Galacs/rollxoxo-shim/rollxoxo-shim.kicad_pcb

## KiCad design rollxoxo-shim.kicad_pcb (2026-06-30)

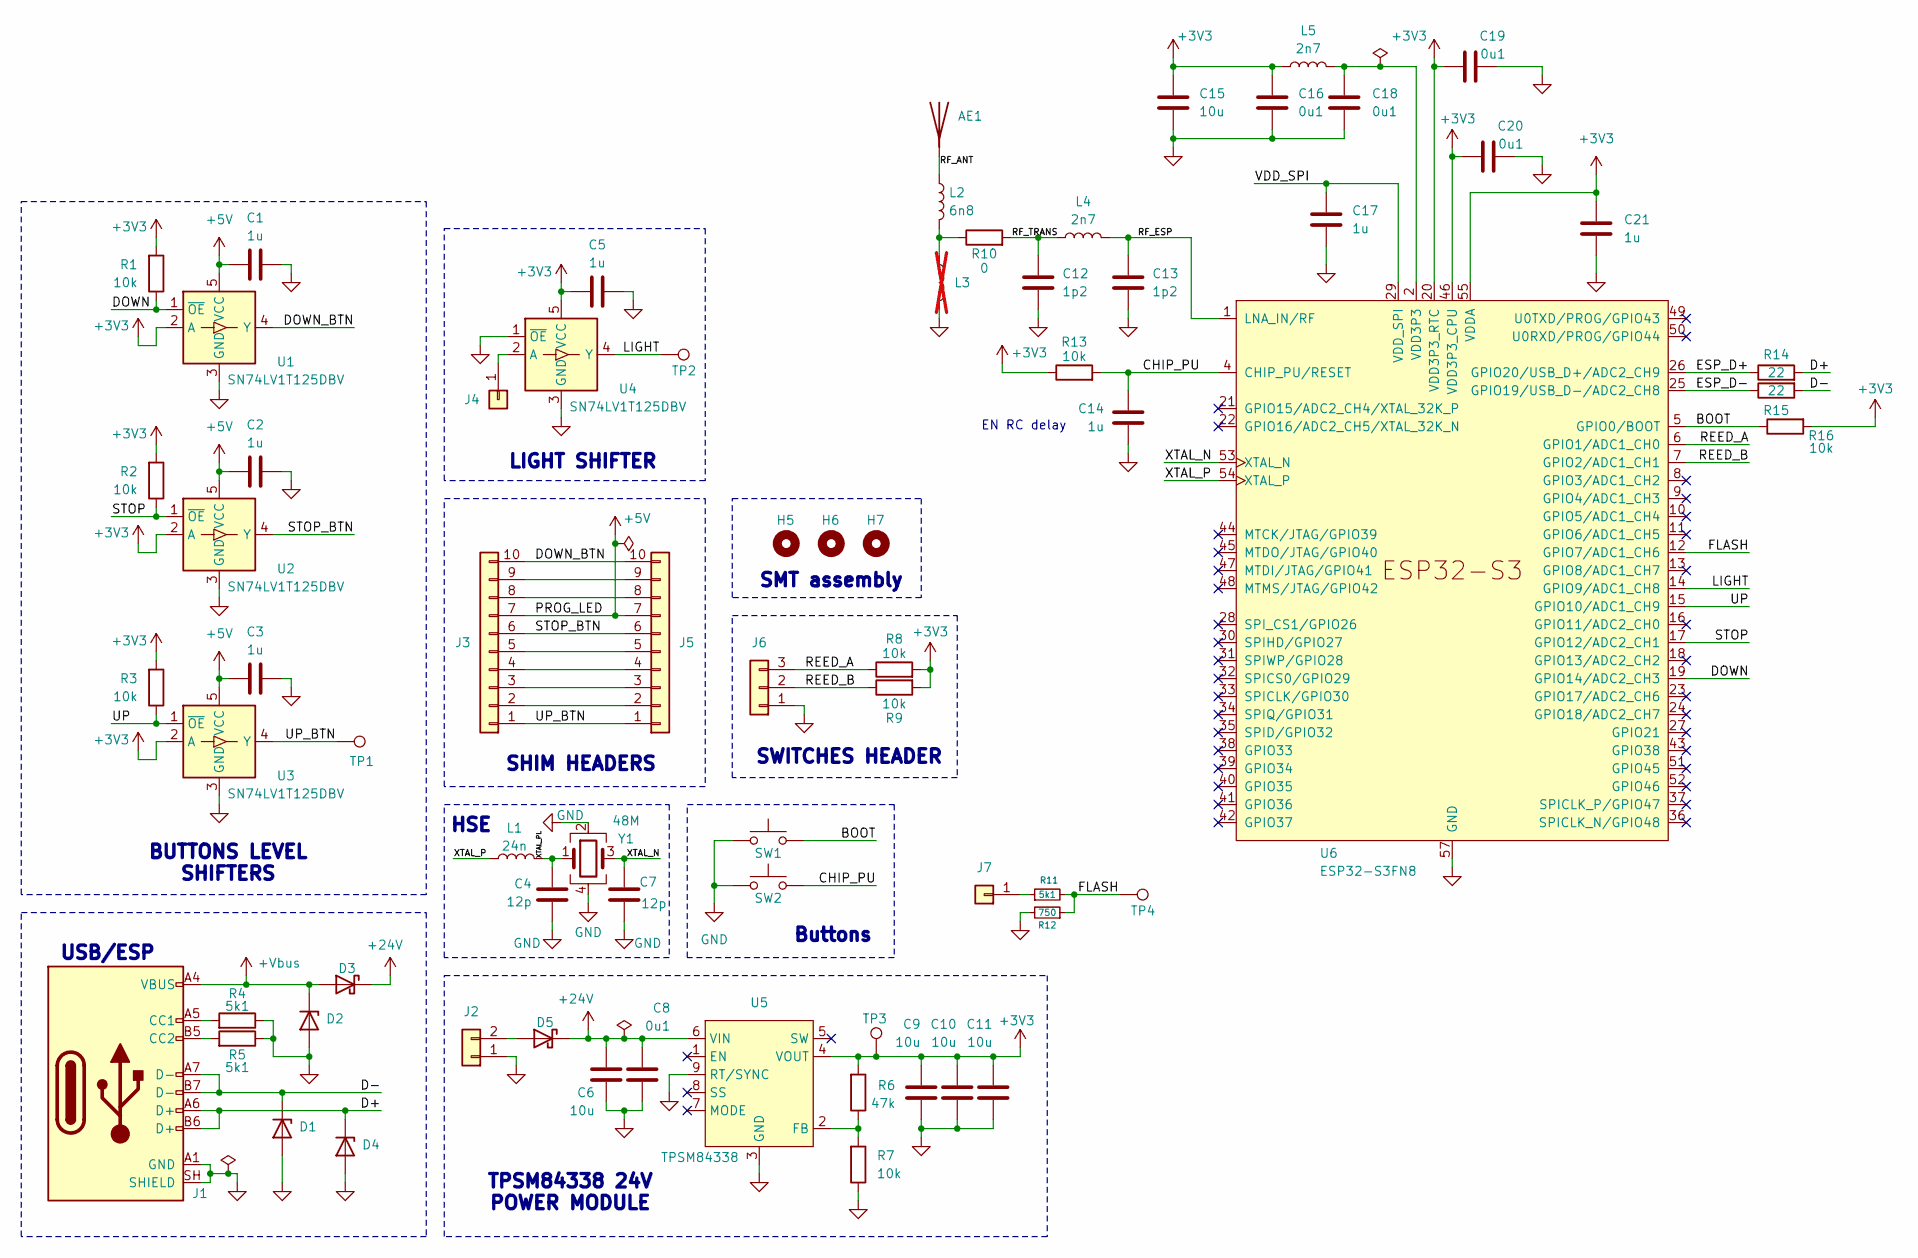
[picture p1: schematic rollxoxo-shim.kicad_sch, Rollxoxo shim]

Parts:
AE1: Antenna; Johanson_2450AT18x100; Manufacturer Part Number RFANT3216120A5T; JLCPCB Part # C127629
C1, C2, C3, C5, C14, C17, C21: 1u; C_0402_1005Metric; Manufacturer Part Number CL05A105KA5NQNC; JLCPCB Part # C52923
C4, C7: 12p; C_0402_1005Metric; Manufacturer Part Number 0402CG120J500NT; JLCPCB Part # C1547
C6, C9, C10, C11: 10u; C_0805_2012Metric; Manufacturer Part Number GRM21BR61H106KE43L; JLCPCB Part # C440198
C8, C16, C18, C19, C20: 0u1; C_0402_1005Metric; Manufacturer Part Number CL05B104KB54PNC; JLCPCB Part # C307331
C12, C13: 1p2; C_0402_1005Metric; Manufacturer Part Number GJM1555C1H1R2WB01D; JLCPCB Part # C76899
C15: 10u; C_0402_1005Metric; Manufacturer Part Number CL05A106MQ5NUNC; JLCPCB Part # C15525
D1, D2, D4: H5VU10U; Diode_DFN1006; Manufacturer Part Number H5VU10U; JLCPCB Part # C22395519
D3, D5: D_Schottky; D_SMA; Manufacturer Part Number SS54; JLCPCB Part # C22452
H5, H6, H7: MountingHole; ToolingHole_1.152mm
J1: USB_C_Receptacle_USB2.0_14P; USB_C_Receptacle_HRO_TYPE-C-31-M-12; Manufacturer Part Number TYPE-C16PIN; JLCPCB Part # C393939
J2: Conn_01x02; JST_XH_B2B-XH-A_1x02_P2.50mm_Vertical
J3: Conn_01x10; PinSocket_1x10_P2.54mm_Horizontal
J4, J7: Conn_01x01; PinHeader_1x01_P2.54mm_Horizontal
J5: Conn_01x10; PinHeader_1x10_P2.54mm_Horizontal
J6: Conn_01x03; JST_XH_S3B-XH-A_1x03_P2.50mm_Horizontal
L1: 24n; L_0402_1005Metric; Manufacturer Part Number LQW15AN24NG00D; JLCPCB Part # C167472
L2: 6n8; L_0402_1005Metric; Manufacturer Part Number LQG15HS6N8J02D; JLCPCB Part # C77110
L3: L; L_0402_1005Metric; not fitted
L4, L5: 2n7; L_0402_1005Metric; Manufacturer Part Number LQG15HS2N7S02D; JLCPCB Part # C77108
R1, R2, R3, R7, R8, R9, R13, R16: 10k; R_0402_1005Metric; Manufacturer Part Number 0402WGF1002TCE; JLCPCB Part # C25744
R4, R5: 5k1; R_0402_1005Metric; Manufacturer Part Number 0402WGF5101TCE; JLCPCB Part # C25905
R6: 47k; R_0402_1005Metric; Manufacturer Part Number 0402WGF4702TCE; JLCPCB Part # C25792
R10: 0; R_0402_1005Metric; Manufacturer Part Number 0402WGF0000TCE; JLCPCB Part # C17168
R11: 5k1; R_0603_1608Metric; Manufacturer Part Number 0603WAF5101T5E; JLCPCB Part # C23186
R12: 750; R_0603_1608Metric; Manufacturer Part Number 0603WAF7500T5E; JLCPCB Part # C23241
R14, R15: 22; R_0402_1005Metric; Manufacturer Part Number 0402WGF220JTCE; JLCPCB Part # C25092
SW1, SW2: SW_Push; SW_SPST_TS-1088-xR020; Manufacturer Part Number TS-1088-AR02016; JLCPCB Part # C720477
TP1, TP2, TP3, TP4: TestPoint; TestPoint_Pad_D1.0mm
U1, U2, U3, U4: SN74LV1T125DBV; SOT-23-5; Manufacturer Part Number SN74LV1T125DBVR; JLCPCB Part # C473338
U5: TPSM84338; Manufacturer Part Number TPSM84338RCJR; JLCPCB Part # C47122151
U6: ESP32-S3FN8; QFN-56-1EP_7x7mm_P0.4mm_EP4x4mm_ThermalVias; Manufacturer Part Number ESP32-S3FH4R2; JLCPCB Part # C3013940
Y1: 48M; Crystal_SMD_2016-4Pin_2.0x1.6mm; Manufacturer Part Number R940000096; JLCPCB Part # C7206306

Connections:
+3V3: C5.1, C9.1, C10.1, C11.1, C15.1, C16.1, C19.1, C20.1, C21.1, L5.1, R1.2, R2.2, R3.2, R6.2, R8.2, R9.2, R13.1, R16.2, TP3.1 (1_1), U1.2 (A), U2.2 (A), U3.2 (A), U4.5 (VCC), U5.4 (VOUT), U6.20 (VDD3P3_RTC), U6.46 (VDD3P3_CPU), U6.55 (VDDA), U6.56 (VDDA)
+5V: C1.1, C2.1, C3.1, J3.7, J5.7, U1.5 (VCC), U2.5 (VCC), U3.5 (VCC)
+24V: C6.1, C8.1, D3.1 (K), D5.1 (K), U5.6 (VIN)
+Vbus: D2.1 (K), D3.2 (A), J1.A4 (VBUS), J1.A9 (VBUS), J1.B4 (VBUS), J1.B9 (VBUS)
/BOOT: R16.1, SW1.2, U6.5 (GPIO0/BOOT)
/CHIP_PU: C14.1, R13.2, SW2.2, U6.4 (CHIP_PU/RESET)
/D+: D4.1 (K), J1.A6 (D+), J1.B6 (D+), R14.2
/D-: D1.1 (K), J1.A7 (D-), J1.B7 (D-), R15.2
/DOWN: R1.1, U1.1 (~OE), U6.19 (GPIO14/ADC2_CH3)
/DOWN_BTN: J3.10, J5.10, U1.4 (Y)
/ESP_D+: R14.1, U6.26 (GPIO20/USB_D+/ADC2_CH9)
/ESP_D-: R15.1, U6.25 (GPIO19/USB_D-/ADC2_CH8)
/FLASH: R11.2, R12.1, TP4.1 (1_1), U6.12 (GPIO7/ADC1_CH6)
/LIGHT: TP2.1 (1_1), U4.4 (Y), U6.14 (GPIO9/ADC1_CH8)
/REED_A: J6.3, R8.1, U6.6 (GPIO1/ADC1_CH0)
/REED_B: J6.2, R9.1, U6.7 (GPIO2/ADC1_CH1)
/RF_ANT: AE1.1 (A_1), L2.1
/RF_ESP: C13.1, L4.2, U6.1 (LNA_IN/RF)
/RF_TRANS: C12.1, L4.1, R10.2
/STOP: R2.1, U2.1 (~OE), U6.17 (GPIO12/ADC2_CH1)
/STOP_BTN: J3.6, J5.6, U2.4 (Y)
/UP: R3.1, U3.1 (~OE), U6.15 (GPIO10/ADC1_CH9)
/UP_BTN: J3.1, J5.1, TP1.1 (1_1), U3.4 (Y)
/VDD_SPI: C17.1, U6.29 (VDD_SPI)
/XTAL_N: C7.1, U6.53 (XTAL_N), Y1.3
/XTAL_P: L1.1, U6.54 (XTAL_P)
/XTAL_PL: C4.2, L1.2, Y1.1
GND: C1.2, C2.2, C3.2, C4.1, C5.2, C6.2, C7.2, C8.2, C9.2, C10.2, C11.2, C12.2, C13.2, C14.2, C15.2, C16.2, C17.2, C18.2, C19.2, C20.2, C21.2, D1.2 (A), D2.2 (A), D4.2 (A), J1.A1 (GND), J1.A12 (GND), J1.B1 (GND), J1.B12 (GND), J1.SH (SHIELD), J2.1, J6.1, L3.2, R4.1, R5.1, R7.1, R12.2, SW1.1, SW2.1, U1.3 (GND), U2.3 (GND), U3.3 (GND), U4.1 (~OE), U4.3 (GND), U5.3 (GND), U5.9 (RT/SYNC), U6.57 (GND), Y1.2, Y1.4
unnamed: D5.2 (A), J2.2
unnamed: J1.A5 (CC1), R4.2
unnamed: J1.B5 (CC2), R5.2
unnamed: J3.2, J5.2
unnamed: J3.3, J5.3
unnamed: J3.4, J5.4
unnamed: J3.5, J5.5
unnamed: J3.8, J5.8
unnamed: J3.9, J5.9
unnamed: J4.1 (Pin_1_1), U4.2 (A)
unnamed: J7.1 (Pin_1_1), R11.1
unnamed: L2.2, L3.1, R10.1
unnamed: R6.1, R7.2, U5.2 (FB)
VDD3P3: C18.1, L5.2, U6.2 (VDD3P3), U6.3 (VDD3P3)

Notes on the sheet:
LIGHT SHIFTER
BUTTONS LEVEL SHIFTERS
SWITCHES HEADER
USB/ESP
SMT assembly
HSE
TPSM84338 24V POWER MODULE
EN RC delay
SHIM HEADERS
Buttons

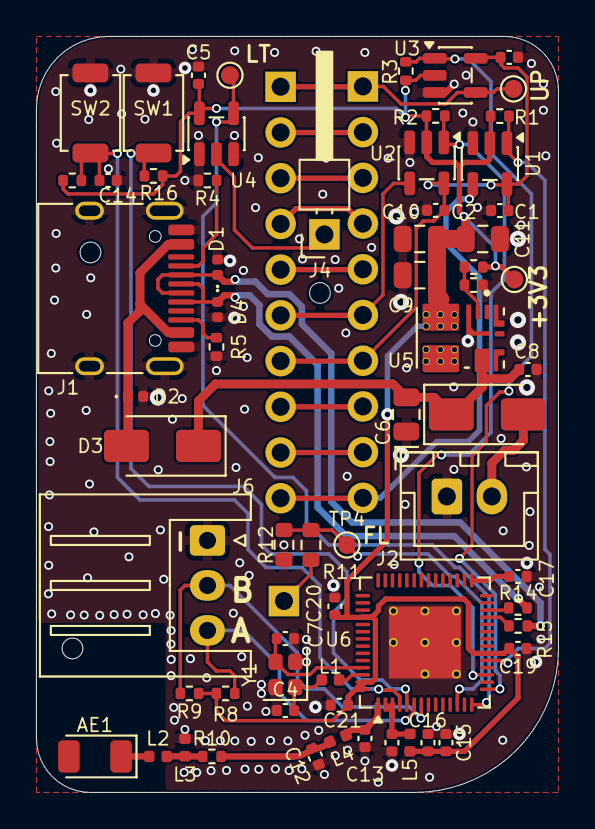
[picture p2: board rollxoxo-shim.kicad_pcb from above]

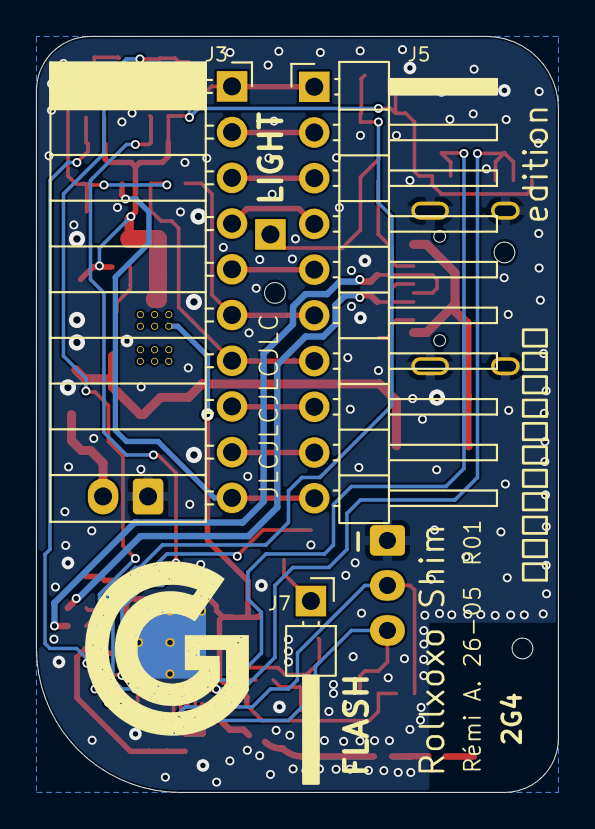
[picture p3: board rollxoxo-shim.kicad_pcb from below]

Board: 4 copper layers, 29.0 x 42.0 mm, 71 parts (3 on the bottom side), 42 nets.
