Galacs/rollxoxo-shim/(commit log)

2026-06-27 schem: import esp32 and support circuits
    [rollxoxo-shim.kicad_sch]
2026-06-27 schem: add SN74LV1T125DBV level shifters
    [rollxoxo-shim.kicad_sch]
2026-06-27 schem: add TPSM84338 24V power module
    [rollxoxo-shim.kicad_sch]
2026-06-27 schem: add LIGHT level shifter
    [rollxoxo-shim.kicad_sch]
2026-06-27 schem: reorganize
    [rollxoxo-shim.kicad_sch]
2026-06-27 schem: add reed switches header
    [rollxoxo-shim.kicad_sch]
2026-06-27 schem: add flash voltage divider input
    [rollxoxo-shim.kicad_sch]
2026-06-27 schem: add test points
    [rollxoxo-shim.kicad_sch]
2026-06-27 schem: connect gpios
    [rollxoxo-shim.kicad_sch]
2026-06-27 schem: add +5v from shim
    [rollxoxo-shim.kicad_sch]
2026-06-27 schem: run and fix ERC
    [rollxoxo-shim.kicad_sch]
2026-06-27 schem: remove uart headers
    [rollxoxo-shim.kicad_sch]
2026-06-27 schem: assign footprints
    [rollxoxo-shim.kicad_sch]
2026-06-27 schem: add ordering info to BOM
    [rollxoxo-shim.kicad_sch]
2026-06-27 schem: add title
    [rollxoxo-shim.kicad_sch]
2026-06-27 schem: renumber
    [rollxoxo-shim.kicad_sch]
2026-06-27 pcb: import jlc 4 layer stackup
    [rollxoxo-shim.kicad_pcb]
2026-06-27 pcb: import footprints from schem
    [rollxoxo-shim.kicad_pcb]
2026-06-27 pcb: add missing 3d model
    [rollxoxo-shim.kicad_pcb]
2026-06-27 pcb: initial rough placement
    [rollxoxo-shim.kicad_pcb, rollxoxo-shim.kicad_sch]
2026-06-27 pcb: add esp32 layout
    [rollxoxo-shim.kicad_pcb]
2026-06-27 pcb: add +3v3 pwr module layout
    [rollxoxo-shim.kicad_pcb]
2026-06-27 pcb: add usb layout
    [rollxoxo-shim.kicad_pcb]
2026-06-27 pcb: add all layout
    [rollxoxo-shim.kicad_pcb]
2026-06-27 pcb: refine layout
    [rollxoxo-shim.kicad_pcb, rollxoxo-shim.kicad_sch]
2026-06-27 pcb: add board outline
    [rollxoxo-shim.kicad_pcb]
2026-06-27 pcb: add gnd planes
    [rollxoxo-shim.kicad_pcb]
2026-06-27 pcb: add rf layout
    [rollxoxo-shim.kicad_pcb]
2026-06-27 pcb: add gnd vias
    [rollxoxo-shim.kicad_pcb]
2026-06-27 pcb: add drill/place origin
    [rollxoxo-shim.kicad_pcb]
2026-06-27 pcb: reorganize programmable gpios
    [rollxoxo-shim.kicad_pcb, rollxoxo-shim.kicad_sch]
2026-06-27 pcb: add rf routing
    [rollxoxo-shim.kicad_pcb]
2026-06-27 pcb: add usb routing
    [rollxoxo-shim.kicad_pcb]
2026-06-27 pcb: add misc routing
    [rollxoxo-shim.kicad_pcb]
2026-06-27 pcb: add power module routing
    [rollxoxo-shim.kicad_pcb]
2026-06-27 pcb: add +3v3 pwr routing
    [rollxoxo-shim.kicad_pcb]
2026-06-27 pcb: add through routing
    [rollxoxo-shim.kicad_pcb]
2026-06-27 pcb: add +5v routing
    [rollxoxo-shim.kicad_pcb]
2026-06-27 pcb: route gpios
    [rollxoxo-shim.kicad_pcb, rollxoxo-shim.kicad_sch]
2026-06-27 pcb: route missing
    [rollxoxo-shim.kicad_pcb]
2026-06-27 pcb: add stiching vias
    [rollxoxo-shim.kicad_pcb]
2026-06-27 pcb: run and fix DRC
    [rollxoxo-shim.kicad_pcb]
2026-06-27 pcb: remove unused internal pads
    [rollxoxo-shim.kicad_pcb]
2026-06-27 pcb(silk): clean reference designators
    [rollxoxo-shim.kicad_pcb]
2026-06-27 pcb(silk): add user txt
    [rollxoxo-shim.kicad_pcb]
2026-06-27 pcb: add title
    [rollxoxo-shim.kicad_pcb]
2026-06-27 generate production files
    [bom.csv, designators.csv, positions.csv]
2026-06-30 schem/pcb: add tooling holes
    [rollxoxo-shim.kicad_pcb, rollxoxo-shim.kicad_sch]
2026-06-30 regenerate production files
    [designators.csv, positions.csv]
